Jajcus/rpp_433mhz_weather_receiver/kicad/rpp_433mhz_weather_receiver.kicad_sch

## KiCad design kicad/rpp_433mhz_weather_receiver.kicad_sch (2023-08-08)

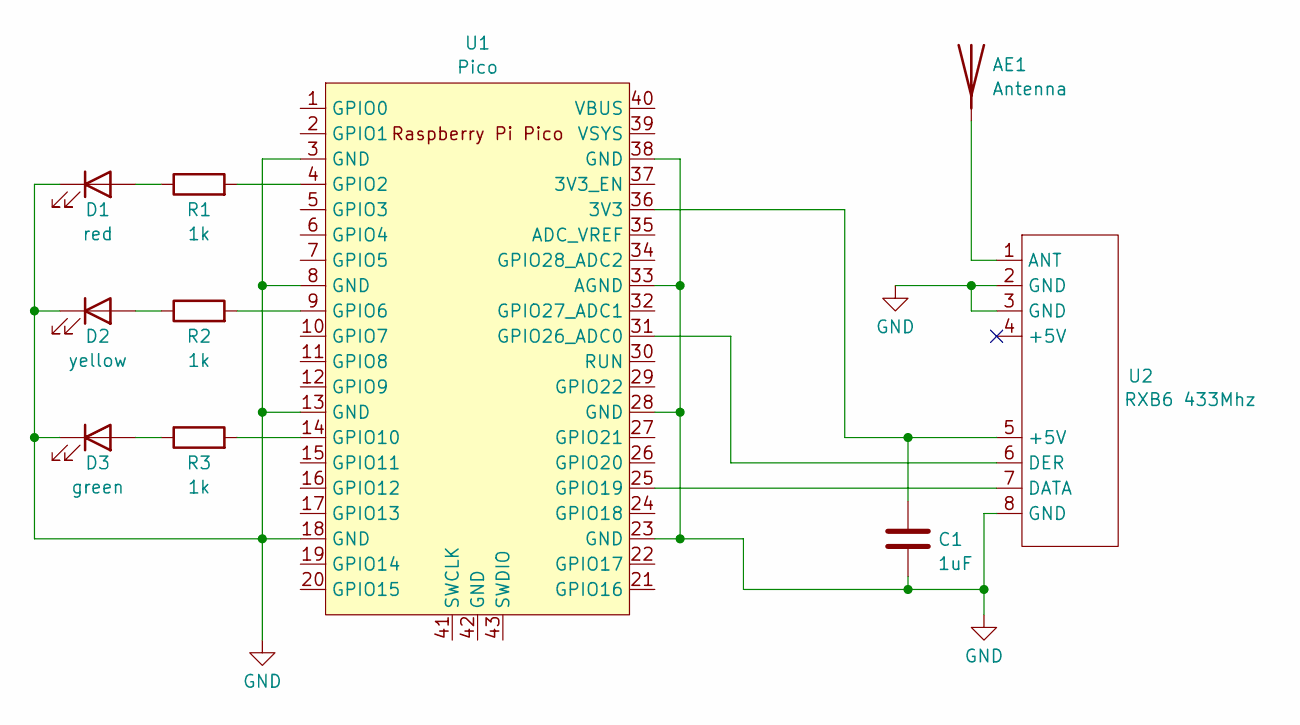
[picture p1: schematic rpp_433mhz_weather_receiver.kicad_sch]

Parts:
AE1: Antenna
C1: 1uF
D1: red
D2: yellow
D3: green
R1, R2, R3: 1k
U1: Pico; RPi_Pico_SMD_TH
U2: RXB6 433Mhz

Connections:
GND: C1.2, D1.1 (K), D2.1 (K), D3.1 (K), U1.3 (GND), U1.8 (GND), U1.13 (GND), U1.18 (GND), U1.23 (GND), U1.28 (GND), U1.33 (AGND), U1.38 (GND), U2.2 (GND), U2.3 (GND), U2.8 (GND)
unnamed: AE1.1, U2.1 (ANT)
unnamed: C1.1, U1.36 (3V3), U2.5 (+5V)
unnamed: D1.2 (A), R1.1
unnamed: D2.2 (A), R2.1
unnamed: D3.2 (A), R3.1
unnamed: R1.2, U1.4 (GPIO2)
unnamed: R2.2, U1.9 (GPIO6)
unnamed: R3.2, U1.14 (GPIO10)
unnamed: U1.25 (GPIO19), U2.7 (DATA)
unnamed: U1.31 (GPIO26_ADC0), U2.6 (DER)
