Jajcus/rpp_433mhz_weather_receiver/src/test_data.rs

use crate::radio::Pulse;
use crate::radio::PulseKind::{High, Low, Reset};

pub const PROLOGUE_TEST_STREAM_L: usize = 545;
pub const PROLOGUE_TEST_STREAM: [Pulse; 545] = [
    Pulse {
        kind: Reset,
        length: 0,
    },
    Pulse {
        kind: High,
        length: 366,
    },
    Pulse {
        kind: Reset,
        length: 0,
    },
    Pulse {
        kind: High,
        length: 933,
    },
    Pulse {
        kind: Low,
        length: 107,
    },
    Pulse {
        kind: High,
        length: 297,
    },
    Pulse {
        kind: Low,
        length: 93,
    },
    Pulse {
        kind: High,
        length: 154,
    },
    Pulse {
        kind: Low,
        length: 79,
    },
    Pulse {
        kind: High,
        length: 432,
    },
    Pulse {
        kind: Reset,
        length: 0,
    },
    Pulse {
        kind: High,
        length: 146,
    },
    Pulse {
        kind: Reset,
        length: 0,
    },
    Pulse {
        kind: High,
        length: 1076,
    },
    Pulse {
        kind: Low,
        length: 155,
    },
    Pulse {
        kind: High,
        length: 600,
    },
    Pulse {
        kind: Low,
        length: 4192,
    },
    Pulse {
        kind: High,
        length: 565,
    },
    Pulse {
        kind: Low,
        length: 2091,
    },
    Pulse {
        kind: High,
        length: 548,
    },
    Pulse {
        kind: Low,
        length: 2105,
    },
    Pulse {
        kind: High,
        length: 532,
    },
    Pulse {
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
        kind: Reset,
        length: 0,
    },
    Pulse {
        kind: High,
        length: 81,
    },
    Pulse {
        kind: Low,
        length: 143,
    },
    Pulse {
        kind: High,
        length: 1711,
    },
    Pulse {
        kind: Low,
        length: 206,
    },
];
