Jajcus/rpp_433mhz_weather_receiver/(commit log)

2023-08-07 Cargo.toml: use local embassy-net-driver from deps/embassy
    it is a dependency of embassy-usb and the published version is outdated
2023-08-07 compute signal level averages and blink leds
    light up 'signal LED' when current signal is at more than 10% higher
    than a minute average
    blink 'data LED' when a data packet is properly decoded
2023-08-07 .cargo/config.toml: remove --measure-stack
    this probe-run option is deprecated now
2023-08-07 update USB id numbers and strings
    – use https://pid.codes/ test PID number
    – use device name matching the GitHub project name
2023-08-08 README: images added, including schematic diagram
    [rpp_433mhz_weather_receiver.kicad_sch]
2023-08-09 latch on sensor id
    For stable output, when multiple sensors on the same channel are around,
    ignore input from unknown ids unless not received anything from the
    known id on the channel for 15 minutes.
2023-08-09 README: add info about the antenna
2023-08-10 include RSSI in json output
    helps tweaking antenna and its location
2023-08-10 README: more about the antenna
2023-08-31 fix lock-up in some reset condition
    [radio.rs]
